sgablot/alarmClock/README.md

# **Alarm Clock v0**

## Présentation
- Création d'une horloge avec buzzer intégrer à l'aide d'un Arduino Nano
- Programmation entièrement en C/CPP (sans librairie arduino)
- Mise en plan du schéma électrique et fabriquation du PCB (soutraitement)
- Création, fabrication et mise en plan du boitier en plastique (Réalisation via impression 3D)

</br>

# License
GABLOT Sylvain 2021-2022
