sgablot/alarmClock/docs/schematics/AlarmClock_sch.pdf

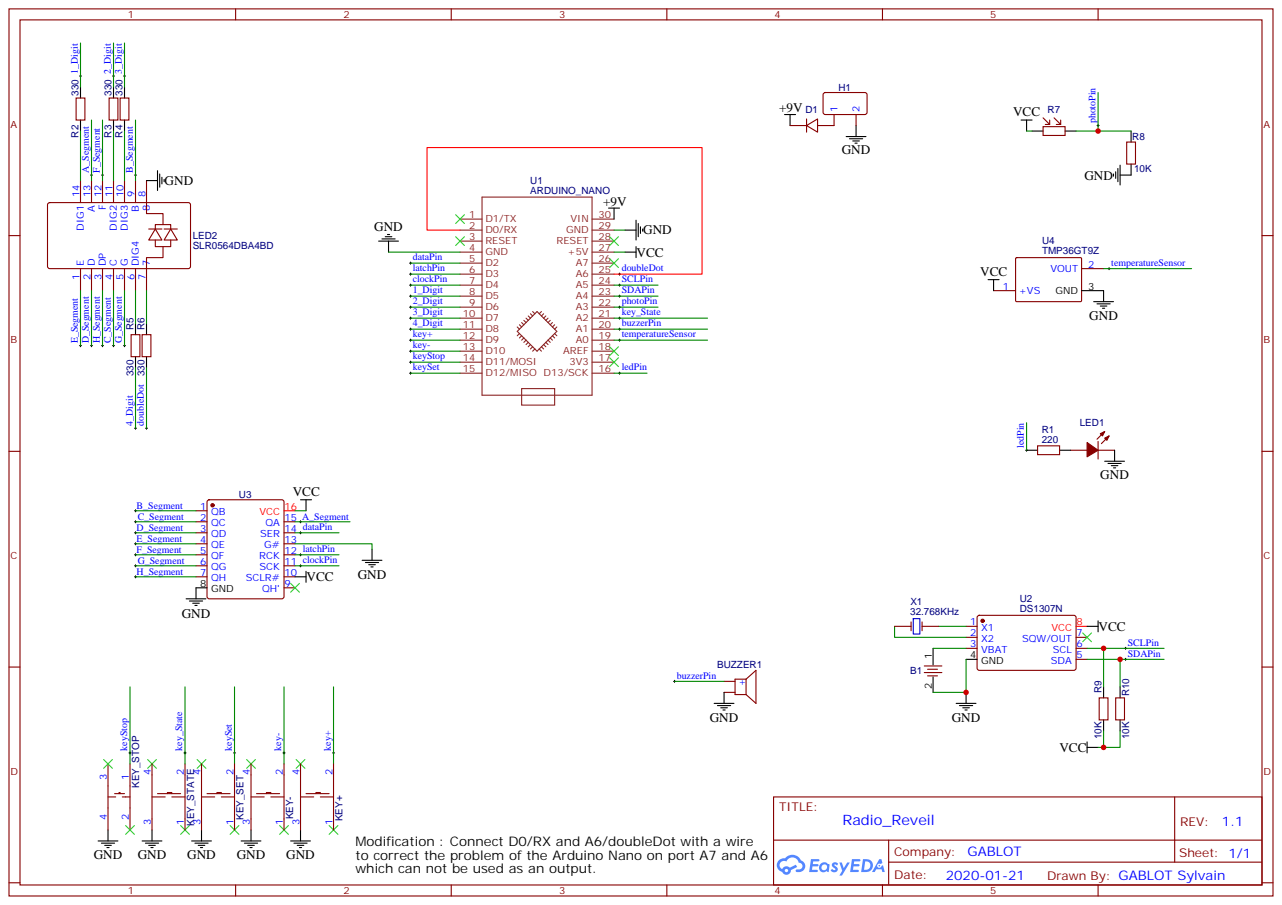
[picture p1: page 1]

Modification : Connect D0/RX and A6/doubleDot with a wire
to correct the problem of the Arduino Nano on port A7 and A6
which can not be used as an output.

Drawn By: GABLOT Sylvain
