sgablot/alarmClock/docs/flowchart/flowchart_v1.0.pdf

## Boucle principale v1.0

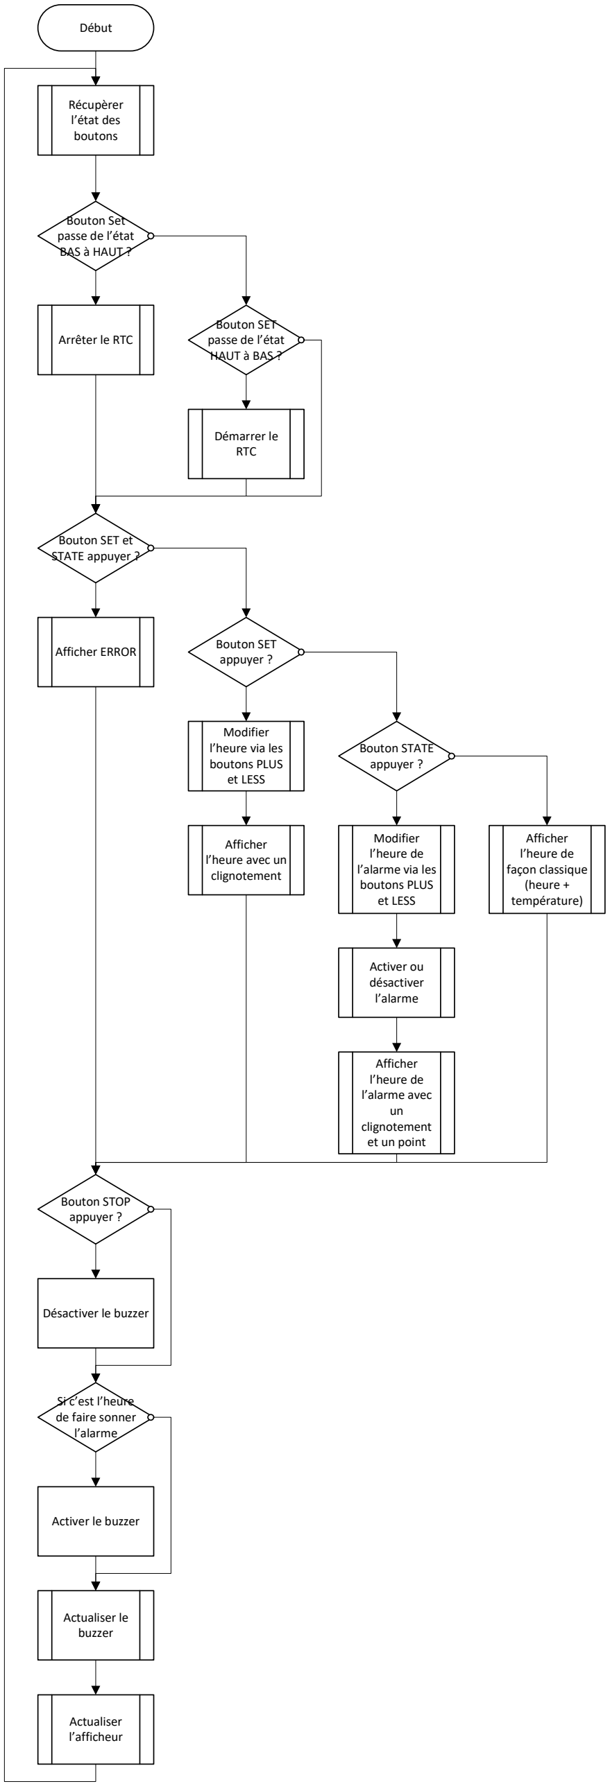
[picture p2: figure]
Début; Récupèrer l’état des boutons; Bouton Set passe de l’état BAS à HAUT ?; Arrêter le RTC; Démarrer le RTC; Bouton SET et STATE appuyer ?; Afficher ERROR; Bouton SET; appuyer ?; Modifier l’heure via les boutons PLUS et LESS; Bouton STATE appuyer ?; Modifier l’heure de l’alarme via les boutons PLUS et LESS; Afficher l’heure avec un clignotement; Activer ou désactiver l’alarme; Afficher l’heure de l’alarme avec un clignotement; et un point; Afficher l’heure de façon classique (heure + température); Bouton STOP appuyer ?; Désactiver le buzzer; Si c’est l’heure de faire sonner l’alarme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

GABLOT | 1/6

## Afficheur v1.0

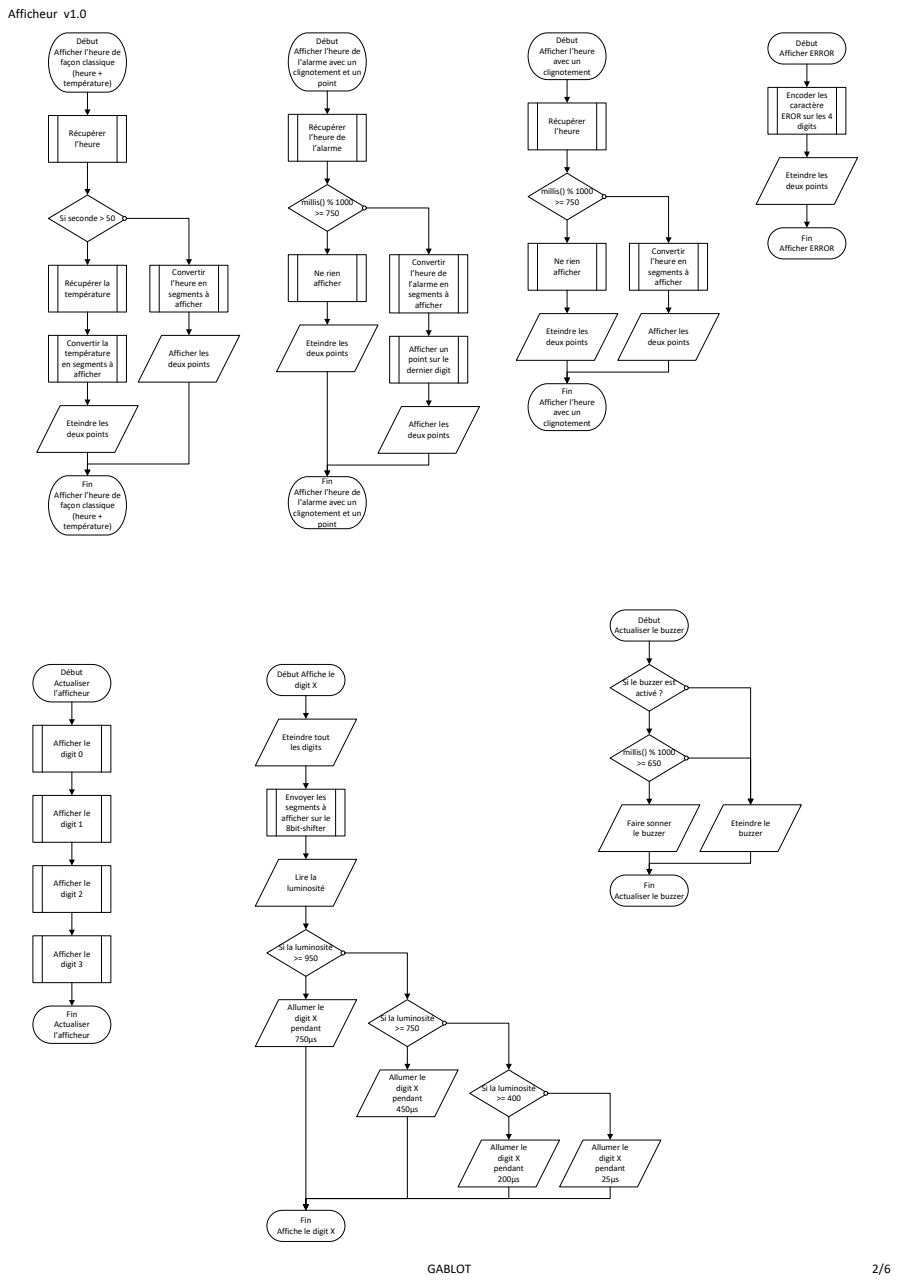
[picture p3: page 2]
GABLOT; Eteindre tout les digits; Allumer le digit X pendant 750µs; Lire la luminosité; Allumer le digit X pendant 450µs; Allumer le digit X pendant 200µs; Allumer le digit X pendant 25µs; Début Actualiser l’afficheur; Afficher le digit 0; Afficher le digit 1; Afficher le digit 2; Afficher le digit 3; Fin Actualiser l’afficheur; Récupérer l’heure; Si seconde > 50; Récupérer la température; Convertir la température en segments à afficher; Convertir l’heure en segments à afficher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

Afficher l’heure de
façon classique
(heure +
température)

l’alarme avec un
clignotement et un
point

Afficher l’heure avec un clignotement

Encoder les
caractère
EROR sur les 4
digits

Afficher un
point sur le
dernier digit

Fin

Début
Actualiser le buzzer

Début Affiche le
digit X

Si le buzzer est
activé ?

Envoyer les
segments à
afficher sur le
8bit-shifter

Si la luminosité

Affiche le digit X

## 8bit-Shifter v1.0

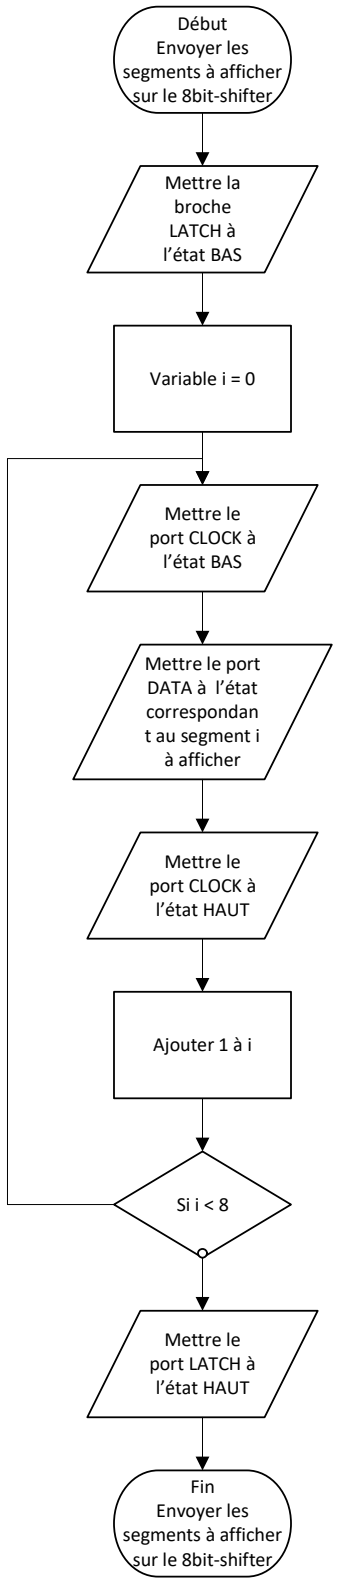
[picture p4: figure]
Début Envoyer les segments à afficher sur le 8bit-shifter; Mettre la broche LATCH à l’état BAS; Variable i = 0; Mettre le port CLOCK à l’état BAS; Mettre le port DATA à l’état correspondan t au segment i à afficher; Mettre le port CLOCK à l’état HAUT; Mettre le port LATCH à l’état HAUT; Ajouter 1 à i; Fin Envoyer les segments à afficher sur le 8bit-shifter

GABLOT | 3/6

## RTC v1.0 Note attention au conversion

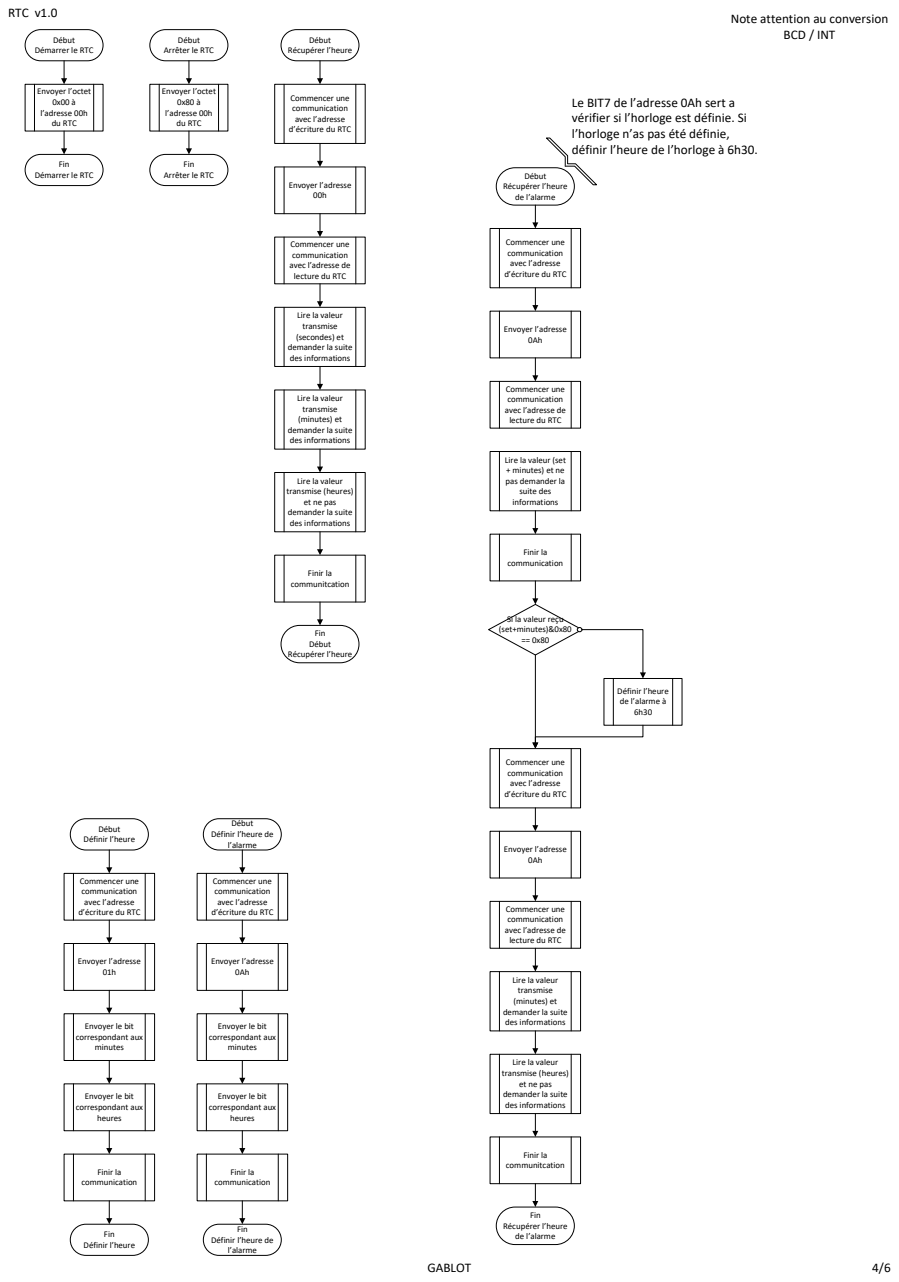
[picture p5: page 4]
GABLOT; Envoyer l’octet 0x80 à l’adresse 00h du RTC; Envoyer l’octet 0x00 à l’adresse 00h du RTC; Récupérer l’heure; Envoyer l’adresse 00h; Finir la communitcation; Fin Début Récupérer l’heure; Début Définir l’heure; Envoyer l’adresse 01h; Finir la communication; Fin Définir l’heure; Envoyer l’adresse 0Ah; BCD / INT; Définir l’heure de l’alarme à 6h30; Début Récupérer l’heure de l’alarme; Fin Récupérer l’heure de l’alarme

Démarrer le RTC

Arrêter le RTC

Commencer une
communication
avec l’adresse
d’écriture du RTC

Le BIT7 de l’adresse 0Ah sert a
vérifier si l’horloge est définie. Si
l’horloge n’as pas été définie,
définir l’heure de l’horloge à 6h30.

Fin

Commencer une communication avec l’adresse de lecture du RTC

Commencer une communication avec l’adresse d’écriture du RTC

Lire la valeur transmise (secondes) et demander la suite des informations

Envoyer l’adresse 0Ah

avec l’adresse de
lecture du RTC

Lire la valeur transmise (minutes) et demander la suite des informations

Lire la valeur (set + minutes) et ne pas demander la suite des informations

Lire la valeur transmise (heures) et ne pas demander la suite des informations

Finir la communication

Si la valeur reçu
(set+minutes)&0x80

Début
Définir l’heure de
l’alarme

Lire la valeur
transmise
(minutes) et
demander la suite
des informations

Envoyer le bit
correspondant aux
minutes

transmise (heures)
et ne pas

heures

## Time v1.0

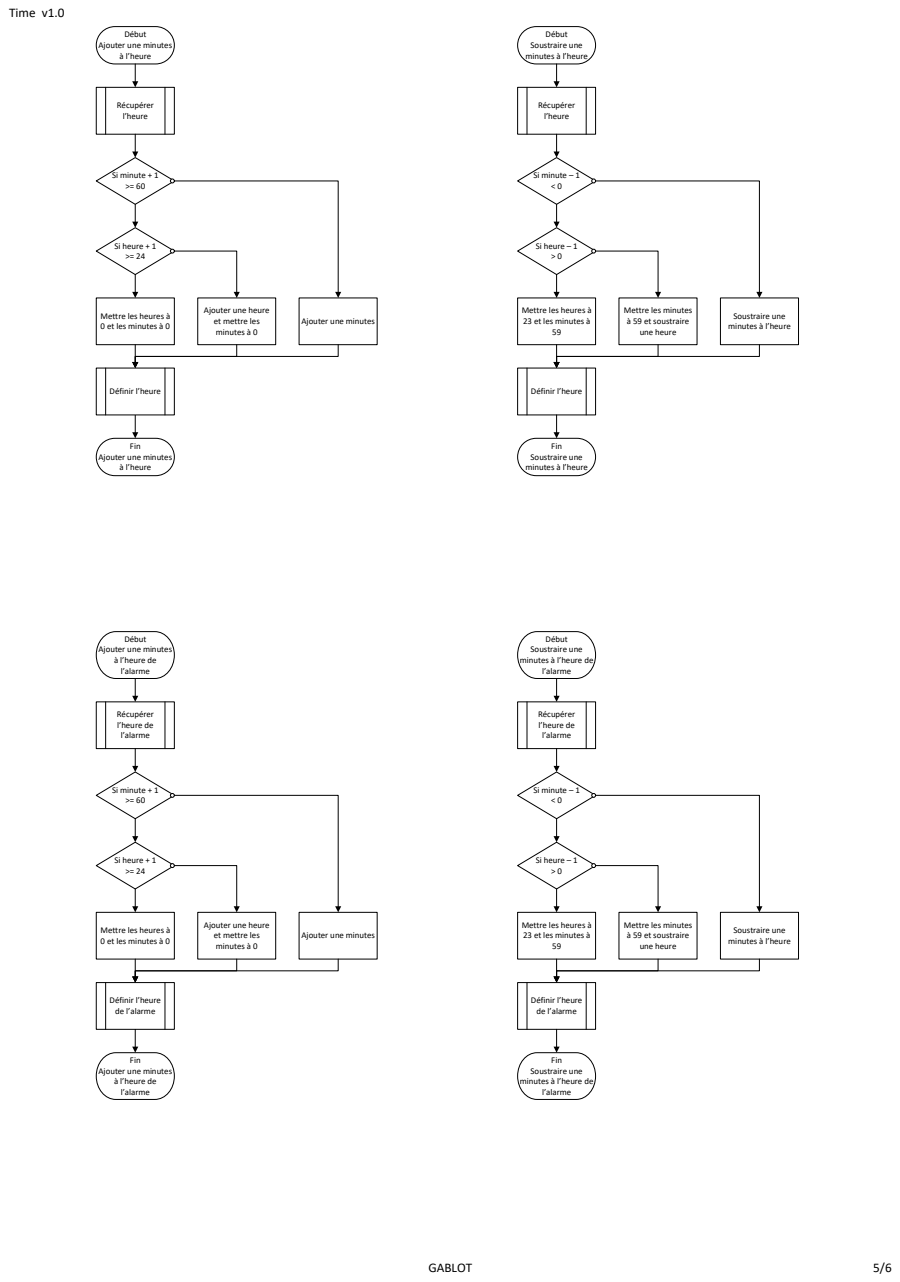
[picture p6: page 5]
GABLOT; Récupérer l’heure; Si minute + 1 >= 60; Si heure + 1 >= 24; Définir l’heure; Récupérer l’heure de l’alarme; Définir l’heure de l’alarme; Si minute – 1 < 0; Si heure – 1 > 0; Soustraire une minutes à l’heure; Fin Soustraire une minutes à l’heure

Ajouter une minutes
à l’heure

Ajouter une heure
et mettre les
minutes à 0

Mettre les heures à
23 et les minutes à

Mettre les minutes
à 59 et soustraire
une heure

0 et les minutes à 0

Fin

Début
à l’heure de
l’alarme

Soustraire une
minutes à l’heure de

## Bouton v1.0

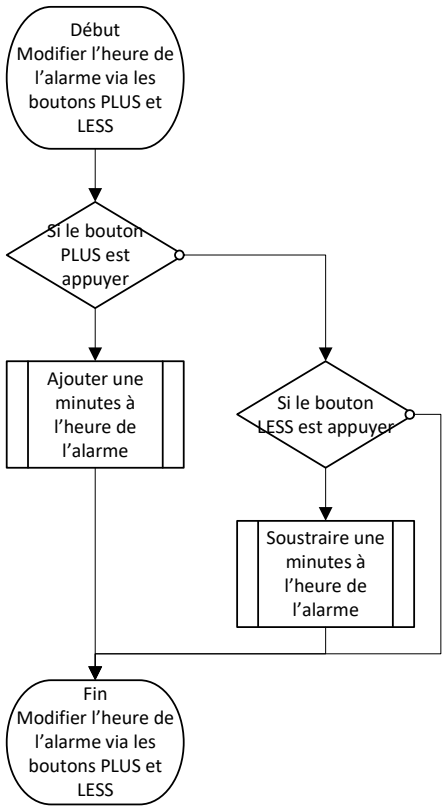
[picture p7: figure]
Début Modifier l’heure de l’alarme via les boutons PLUS et LESS; Si le bouton PLUS est appuyer; Ajouter une minutes à l’heure de l’alarme; Si le bouton LESS est appuyer; Soustraire une minutes à l’heure de l’alarme; Fin Modifier l’heure de l’alarme via les boutons PLUS et LESS

GABLOT | 6/6

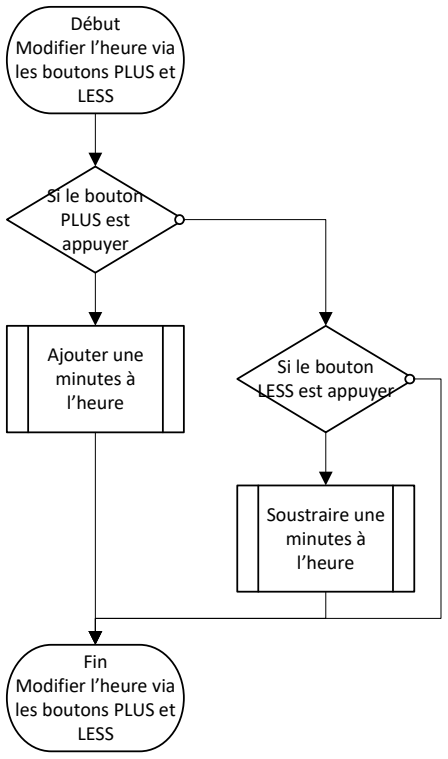
[picture p8: figure]
Début Modifier l’heure via les boutons PLUS et LESS; Si le bouton PLUS est appuyer; Ajouter une minutes à l’heure; Si le bouton LESS est appuyer; Soustraire une minutes à l’heure; Fin Modifier l’heure via les boutons PLUS et LESS
