sgablot/alarmClock/(commit log)

2021-12-29 feat(button): add push and toggle button without debouncing system
2021-12-29 feat(button): add debounce system with Timer0
2021-12-29 feat(button): add isPressed and isReleased | modify debounce system
2021-12-30 feat(display): printDigit with 8Bit Shifter
    Also add doc: ThruthTable for 7Segement
    [ThurhtTable_7Segment.xlsx]
2021-12-30 feat(display): add all private function [printClock, printTemperature]
